dlofstrom/LPC1517-QEI/README.md

# LPC1517-QEI
This repository contains source files for a 3-Axis Gimbal using the NXP LPC1517.

Also there are a code example showing how to interfaces a quadrature encoder on the NXP LPC1517 using LPCXpresso.
