dlofstrom/LPC1517-QEI/pcb/assembly/Stencil_02mm.stl

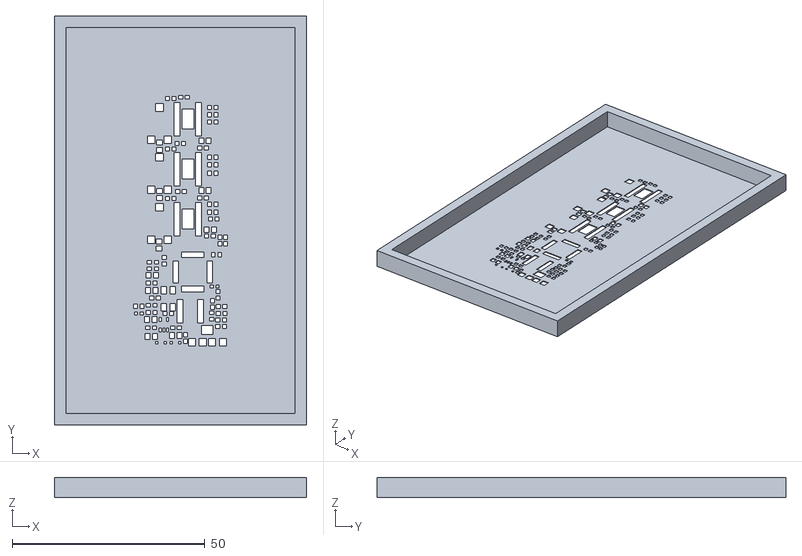
[picture p1: CAD file, 2017-02-09]
pcb/assembly/Stencil_02mm.stl
65.4 x 106.0 x 5.20
