dlofstrom/LPC1517-QEI/pcb/assembly/Assembly_drawing.pdf

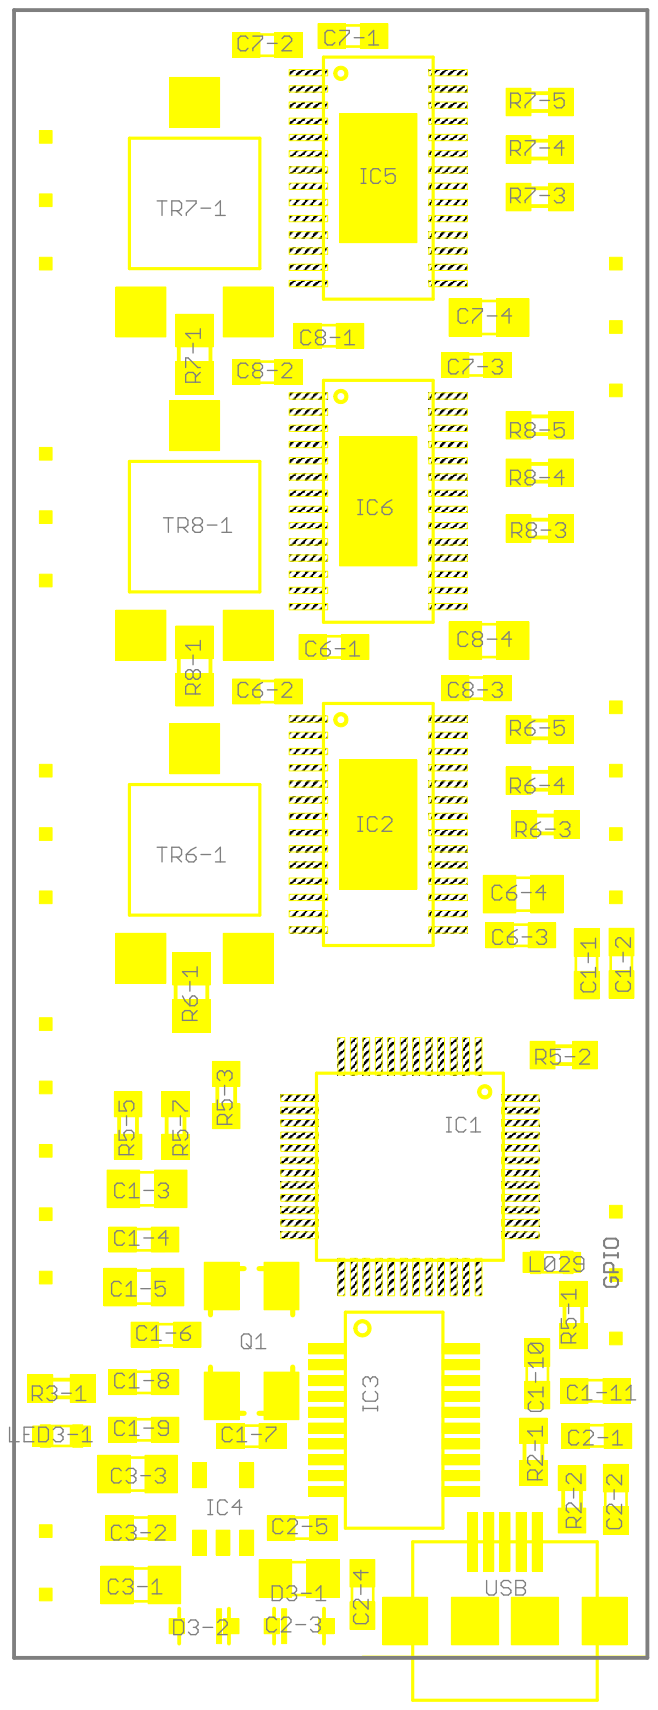
[picture p2: page 1]
