dlofstrom/LPC1517-QEI/pcb/lpcdev/lpcdev.brd

## EAGLE design pcb/lpcdev/lpcdev.brd (2016-10-18)

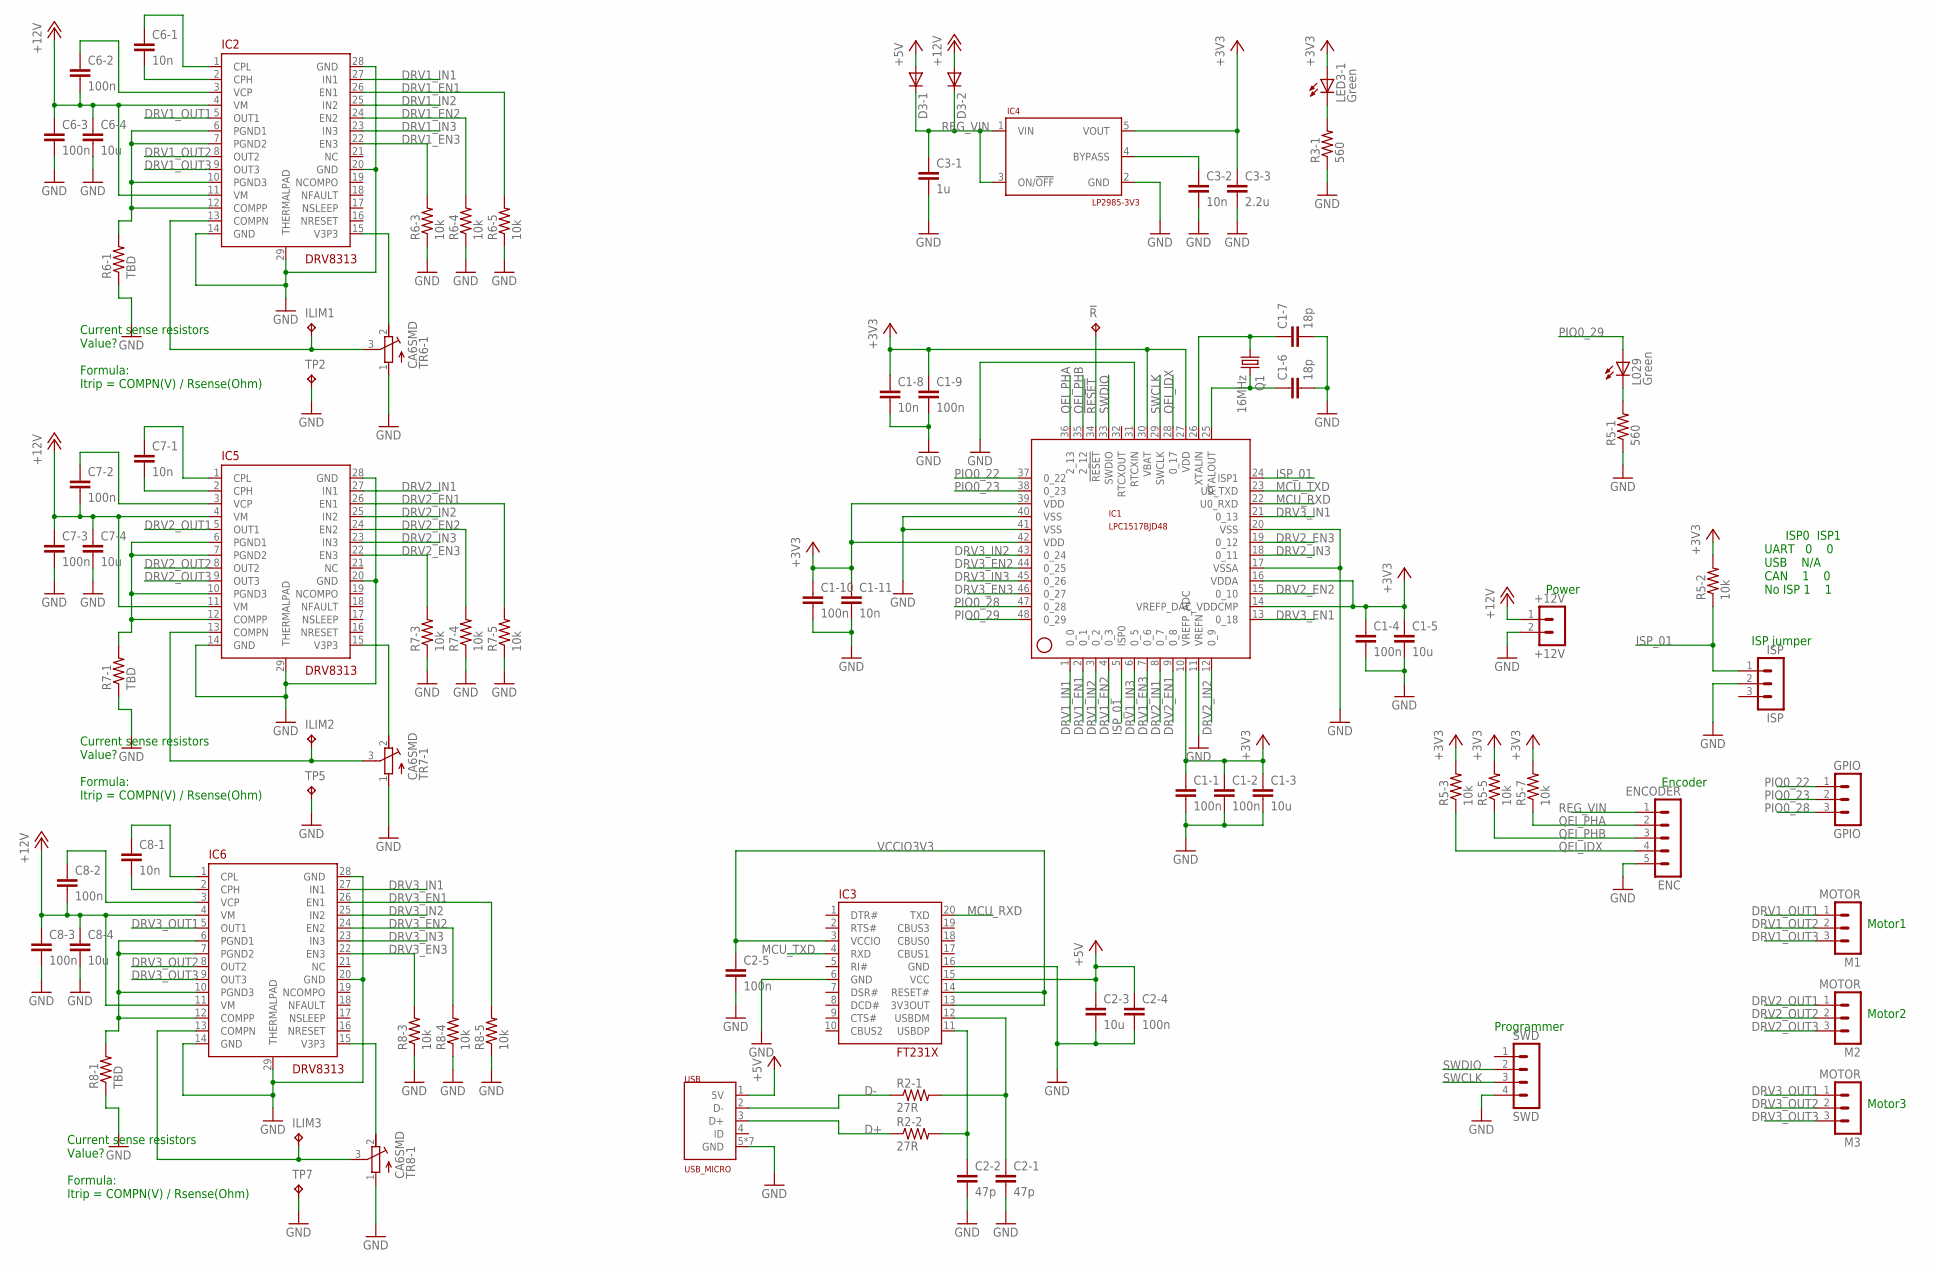
[picture p3: schematic lpcdev.sch]

Parts:
!R: TPB1,27; B1,27
+12V: +12V; MA02-1
C1-1, C1-2, C1-4, C1-9, C1-10, C2-4, C2-5, C6-2, C6-3, C7-2, C7-3, C8-2, C8-3: 100n; C0603
C1-3, C1-5, C2-3, C6-4, C7-4, C8-4: 10u; C0805
C1-6, C1-7: 18p; C0603
C1-8, C1-11, C3-2, C6-1, C7-1, C8-1: 10n; C0603
C2-1, C2-2: 47p; C0603
C3-1: 1u; C0805
C3-3: 2.2u; C0805
D3-1, D3-2: DIODE-SOD323-R; SOD323-R
ENC: ENCODER; MA05-1
GPIO: GPIO; MA03-1
IC1: LPC1517BJD48; LQFP48
IC2, IC5, IC6: DRV8313; R-PDSO-G28
IC3: FT231X; SSOP-20
IC4: LP2985-3V3; SOT23
ILIM1, ILIM2, ILIM3: TPB1,27; B1,27
ISP: ISP; MA03-1
L029: Green; CHIP-LED0603
LED3-1: Green; CHIP-LED0603
M1, M2, M3: MOTOR; MA03-1
Q1: 16MHz; CTS406
R2-1, R2-2: 27R; R0603
R3-1, R5-1: 560; R0603
R5-2, R5-3, R5-5, R5-7, R6-3, R6-4, R6-5, R7-3, R7-4, R7-5, R8-3, R8-4, R8-5: 10k; R0603
R6-1, R7-1, R8-1: TBD; R0805
SWD: SWD; MA04-1
TP2, TP5, TP7: TPB1,27; B1,27
TR6-1, TR7-1, TR8-1: CA6SMD
USB: USB_MICRO

Connections:
!RESET: !R.TP, IC1.34 (!RESET)
+3V3: C1-1.1, C1-2.1, C1-3.1, C1-4.1, C1-5.1, C1-8.1, C1-9.1, C1-10.1, C1-11.1, C3-3.1, IC1.10 (VREFP_ADC), IC1.14 (VREFP_DAC_VDDCMP), IC1.16 (VDDA), IC1.27 (VDD), IC1.30 (VBAT), IC1.39 (VDD), IC1.42 (VDD), IC4.5 (VOUT), LED3-1.A, R5-2.2, R5-3.2, R5-5.2, R5-7.2
+5V: C2-3.1, C2-4.1, D3-1.A, IC3.15 (VCC), USB.1 (5V)
+12V: +12V.1, C6-2.2, C6-3.1, C6-4.1, C7-2.2, C7-3.1, C7-4.1, C8-2.2, C8-3.1, C8-4.1, D3-2.A, IC2.4 (VM), IC2.11 (VM), IC5.4 (VM), IC5.11 (VM), IC6.4 (VM), IC6.11 (VM)
D+: R2-2.1, USB.3 (D+)
D-: R2-1.1, USB.2 (D-)
DRV1_3V3: IC2.15 (V3P3), TR6-1.2 (E)
DRV1_COMPN: IC2.13 (COMPN), ILIM1.TP, TR6-1.3 (S)
DRV1_COMPP: IC2.6 (PGND1), IC2.7 (PGND2), IC2.10 (PGND3), IC2.12 (COMPP), R6-1.2
DRV1_CPH: C6-1.2, IC2.2 (CPH)
DRV1_CPL: C6-1.1, IC2.1 (CPL)
DRV1_EN1: IC1.2 (0_1), IC2.26 (EN1), R6-5.2
DRV1_EN2: IC1.4 (0_3), IC2.24 (EN2), R6-4.2
DRV1_EN3: IC1.7 (0_6), IC2.22 (EN3), R6-3.2
DRV1_IN1: IC1.1 (0_0), IC2.27 (IN1)
DRV1_IN2: IC1.3 (0_2), IC2.25 (IN2)
DRV1_IN3: IC1.6 (0_5), IC2.23 (IN3)
DRV1_OUT1: IC2.5 (OUT1), M1.1
DRV1_OUT2: IC2.8 (OUT2), M1.2
DRV1_OUT3: IC2.9 (OUT3), M1.3
DRV1_VCP: C6-2.1, IC2.3 (VCP)
DRV2_3V1: IC5.15 (V3P3), TR7-1.2 (E)
DRV2_COMPN1: IC5.13 (COMPN), ILIM2.TP, TR7-1.3 (S)
DRV2_COMPP1: IC5.6 (PGND1), IC5.7 (PGND2), IC5.10 (PGND3), IC5.12 (COMPP), R7-1.2
DRV2_CPH1: C7-1.2, IC5.2 (CPH)
DRV2_CPL1: C7-1.1, IC5.1 (CPL)
DRV2_EN1: IC1.9 (0_8), IC5.26 (EN1), R7-5.2
DRV2_EN2: IC1.15 (0_10), IC5.24 (EN2), R7-4.2
DRV2_EN3: IC1.19 (0_12), IC5.22 (EN3), R7-3.2
DRV2_IN1: IC1.8 (0_7), IC5.27 (IN1)
DRV2_IN2: IC1.12 (0_9), IC5.25 (IN2)
DRV2_IN3: IC1.18 (0_11), IC5.23 (IN3)
DRV2_OUT1: IC5.5 (OUT1), M2.1
DRV2_OUT2: IC5.8 (OUT2), M2.2
DRV2_OUT3: IC5.9 (OUT3), M2.3
DRV2_VCP1: C7-2.1, IC5.3 (VCP)
DRV3_3V2: IC6.15 (V3P3), TR8-1.2 (E)
DRV3_COMPN2: IC6.13 (COMPN), ILIM3.TP, TR8-1.3 (S)
DRV3_COMPP2: IC6.6 (PGND1), IC6.7 (PGND2), IC6.10 (PGND3), IC6.12 (COMPP), R8-1.2
DRV3_CPH2: C8-1.2, IC6.2 (CPH)
DRV3_CPL2: C8-1.1, IC6.1 (CPL)
DRV3_EN1: IC1.13 (0_18), IC6.26 (EN1), R8-5.2
DRV3_EN2: IC1.44 (0_25), IC6.24 (EN2), R8-4.2
DRV3_EN3: IC1.46 (0_27), IC6.22 (EN3), R8-3.2
DRV3_IN1: IC1.21 (0_13), IC6.27 (IN1)
DRV3_IN2: IC1.43 (0_24), IC6.25 (IN2)
DRV3_IN3: IC1.45 (0_26), IC6.23 (IN3)
DRV3_OUT1: IC6.5 (OUT1), M3.1
DRV3_OUT2: IC6.8 (OUT2), M3.2
DRV3_OUT3: IC6.9 (OUT3), M3.3
DRV3_VCP2: C8-2.1, IC6.3 (VCP)
GND: +12V.2, C1-1.2, C1-2.2, C1-3.2, C1-4.2, C1-5.2, C1-6.2, C1-7.2, C1-8.2, C1-9.2, C1-10.2, C1-11.2, C2-1.2, C2-2.2, C2-3.2, C2-4.2, C2-5.2, C3-1.2, C3-2.2, C3-3.2, C6-3.2, C6-4.2, C7-3.2, C7-4.2, C8-3.2, C8-4.2, ENC.5, IC1.11 (VREFN), IC1.17 (VSSA), IC1.20 (VSS), IC1.31 (RTCXIN), IC1.40 (VSS), IC1.41 (VSS), IC2.14 (GND), IC2.20 (GND), IC2.28 (GND), IC2.29 (THERMALPAD), IC3.6 (GND), IC3.16 (GND), IC4.2 (GND), IC5.14 (GND), IC5.20 (GND), IC5.28 (GND), IC5.29 (THERMALPAD), IC6.14 (GND), IC6.20 (GND), IC6.28 (GND), IC6.29 (THERMALPAD), ISP.2, R3-1.1, R5-1.1, R6-1.1, R6-3.1, R6-4.1, R6-5.1, R7-1.1, R7-3.1, R7-4.1, R7-5.1, R8-1.1, R8-3.1, R8-4.1, R8-5.1, SWD.4, TP2.TP, TP5.TP, TP7.TP, TR6-1.1 (A), TR7-1.1 (A), TR8-1.1 (A), USB.5 (GND), USB.H1 (GND), USB.H2 (GND), USB.S1 (GND), USB.S2 (GND), USB.S3 (GND), USB.S4 (GND)
ISP_01: IC1.5 (ISP0), IC1.24 (ISP1), ISP.1, R5-2.1
LED1: L029.C, R5-1.2
LED2: LED3-1.C, R3-1.2
MCU_RXD: IC1.22 (U0_RXD), IC3.20 (TXD)
MCU_TXD: IC1.23 (U0_TXD), IC3.4 (RXD)
PIO0_22: GPIO.1, IC1.37 (0_22)
PIO0_23: GPIO.2, IC1.38 (0_23)
PIO0_28: GPIO.3, IC1.47 (0_28)
PIO0_29: IC1.48 (0_29), L029.A
QEI_IDX: ENC.4, IC1.28 (0_17), R5-3.1
QEI_PHA: ENC.2, IC1.36 (2_13), R5-7.1
QEI_PHB: ENC.3, IC1.35 (2_12), R5-5.1
REG_BYPASS: C3-2.1, IC4.4 (BYPASS)
REG_VIN: C3-1.1, D3-1.C, D3-2.C, ENC.1, IC4.1 (VIN), IC4.3 (ON/!OFF)
SWCLK: IC1.29 (SWCLK), SWD.3
SWDIO: IC1.33 (SWDIO), SWD.2
USBDM: C2-1.1, IC3.12 (USBDM), R2-1.2
USBDP: C2-2.1, IC3.11 (USBDP), R2-2.2
VCCIO3V3: C2-5.1, IC3.3 (VCCIO), IC3.13 (3V3OUT), IC3.14 (RESET#)
XTALIN: C1-7.1, IC1.26 (XTALIN), Q1.1
XTALOUT: C1-6.1, IC1.25 (XTALOUT), Q1.3 (2)

Notes on the sheet:
ISP0 ISP1 UART 0 0 USB N/A CAN 1 0 No ISP 1 1
ISP jumper
Encoder
Motor3
Current sense resistors Value? Formula: Itrip = COMPN(V) / Rsense(Ohm)
Programmer
Power
Motor1
Motor2

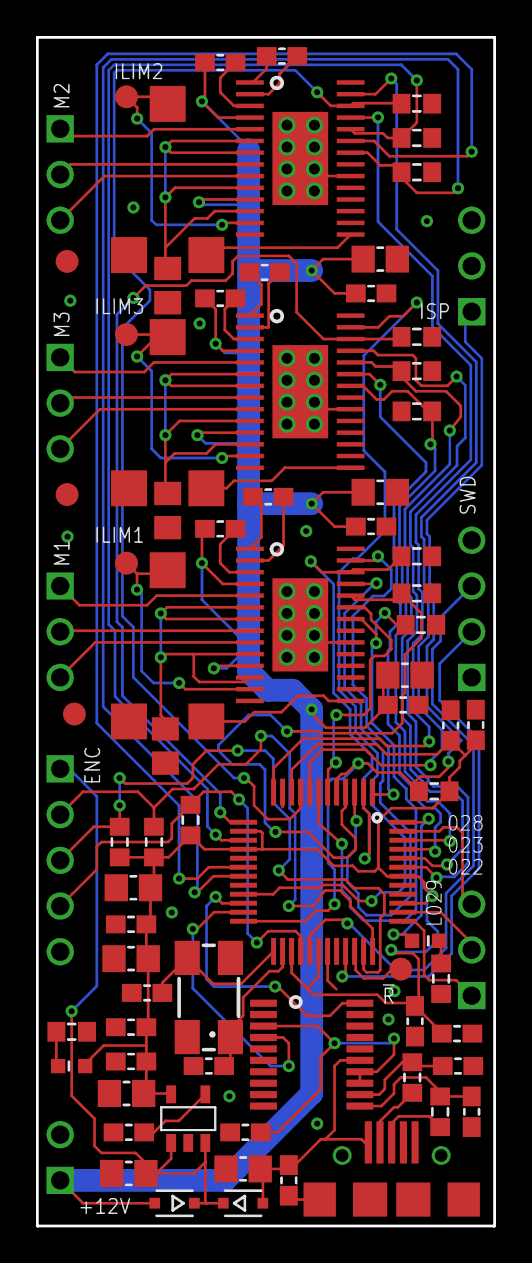
[picture p4: board lpcdev.brd from above]

Board: 2 copper layers, 25.4 x 66.0 mm, 81 parts (0 on the bottom side), 73 nets.
