dlofstrom/LPC1517-QEI/(commit log)

2016-03-31 Serial printout working example
2016-10-05 Schematic for development board
    [lpcdev.sch]
2016-10-07 Added two more motor drivers, named nets and made first pass on board placement
    [lpcdev.brd, lpcdev.sch]
2016-10-08 rough routing (no gnd)
    [lpcdev.brd, lpcdev.sch]
2016-10-15 Routing complete, ERC and DRC is OK
    [lpcdev.brd, lpcdev.sch]
2016-10-18 final touchup and gerber generating
    [lpcdev.brd, lpcdev.sch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]
2017-02-09 Assembly instructions added
    [Stencil_02mm.stl]
